aditelik/bldc_controller/AutoBOM.xlsx

ref | value5 | footprint | part | description | Min Quantity | Status
C1 | 10uF | Capacitor_SMD:C_0805_2012Metric_Pad1.15x1.40mm_HandSolder | C_Small | Unpolarized capacitor, small symbol | 2 | None
C10 | 1uF | Capacitor_SMD:C_0805_2012Metric_Pad1.15x1.40mm_HandSolder | C | Unpolarized capacitor | 4 | None
C12 | 0.1uF | Capacitor_SMD:C_0805_2012Metric_Pad1.15x1.40mm_HandSolder | C_Small | Unpolarized capacitor, small symbol | 14 | None
C15 | 22uF | Capacitor_SMD:C_0805_2012Metric_Pad1.15x1.40mm_HandSolder | C | Unpolarized capacitor | 2 | None
C18 | 22pF | Capacitor_SMD:C_0805_2012Metric_Pad1.15x1.40mm_HandSolder | C_Small | Unpolarized capacitor, small symbol | 2 | None
C27 | 10nF | Capacitor_SMD:C_0805_2012Metric_Pad1.15x1.40mm_HandSolder | C_Small | Unpolarized capacitor, small symbol | 1 | None
C28 | 22nF | Capacitor_SMD:C_0805_2012Metric_Pad1.15x1.40mm_HandSolder | C | Unpolarized capacitor | 3 | None
C31 | 1nF | Capacitor_SMD:C_0805_2012Metric_Pad1.15x1.40mm_HandSolder | C_Small | Unpolarized capacitor, small symbol | 1 | None
C32 | 100pF | Capacitor_SMD:C_0805_2012Metric_Pad1.15x1.40mm_HandSolder | C_Small | Unpolarized capacitor, small symbol | 1 | None
C34 | 0.47uF | Capacitor_SMD:C_0805_2012Metric_Pad1.15x1.40mm_HandSolder | C | Unpolarized capacitor | 3 | None
C5 | 0.33uF | Capacitor_SMD:C_0805_2012Metric_Pad1.15x1.40mm_HandSolder | C | Unpolarized capacitor | 1 | None
C6 | 0.22uF | Capacitor_SMD:C_0805_2012Metric_Pad1.15x1.40mm_HandSolder | C | Unpolarized capacitor | 1 | None
D10 | BAT54HT1G | Diode_SMD:D_SOD-323_HandSoldering | 1N914 | 100V 0.3A Small Signal Fast Switching Diode, DO-35 | 2 | None
D12 | SMF12A | Diode_SMD:D_SOD-123F | D_Zener | Zener diode | 1 | None
D13 | SMF5.0A | Diode_SMD:D_SOD-123F | D_Zener | Zener diode | 1 | None
D14 | 1N5819 | Diode_SMD:D_SOD-123 | 1N5818 | 30V 1A Schottky Barrier Rectifier Diode, DO-41 | 3 | None
D2 | LTST-C171KRKT | LED_SMD:LED_0805_2012Metric_Pad1.15x1.40mm_HandSolder | Green LED | Light emitting diode | 5 | None
D3 | LTST-C171GKT | LED_SMD:LED_0805_2012Metric_Pad1.15x1.40mm_HandSolder | Red LED | Light emitting diode | 1 | None
D4 | LTST-C171GKT | LED_SMD:LED_0805_2012Metric_Pad1.15x1.40mm_HandSolder | Blue LED | Light emitting diode | 1 | None
D8 | SMF10A | Diode_SMD:D_SOD-123F | D_Zener | Zener diode | 1 | None
F1 | 5A Fuse | Fuse:Fuse_1206_3216Metric_Pad1.42x1.75mm_HandSolder | Fuse | Fuse | 1 | None
FB1 | BL01RN1A1D2B | Ferrite_THT:Ferrite_Bead_TH | Ferrite_Bead | Ferrite bead | 1 | None
J1 | Conn_01x06_Male | Connector_PinHeader_2.54mm:PinHeader_1x06_P2.54mm_Vertical | Conn_01x06_Male | Generic connector, single row, 01x06, script generated (kicad-library-utils/schlib/autogen/connector/) | 1 | None
J2 | Screw_Terminal_01x04 | Connector:Terminal_Block_4Pin_TH | Screw_Terminal_01x04 | Generic screw terminal, single row, 01x04, script generated (kicad-library-utils/schlib/autogen/connector/) | 1 | None
Q1 |  | Package_TO_SOT_SMD:SOT-23 |  | P-Channel MOSFET, SOT-23 | 1 | None
Q10 | IRLB8721PBF | Package_TO_SOT_THT:TO-220-3_Vertical | IRLB8721PBF | 62A Id, 30V Vds, N-Channel MOSFET, TO-220 | 1 | Some
Q3 | DMN65D8L-7 | Package_TO_SOT_SMD:SOT-23 | DMN67D7L | 0.21A Id, 60V Vds, N-Channel MOSFET, SOT-23 | 2 | None
Q4 | MMBT3904 | Package_TO_SOT_SMD:SOT-23 | MMBT3904 | 0.2A Ic, 40V Vce, Small Signal NPN Transistor, SOT-23 | 1 | None
Q5 | IRF4905 | Package_TO_SOT_THT:TO-220-3_Vertical | IRF4905 | -74A Id, -55V Vds, Single P-Channel HEXFET Power MOSFET, 20mOhm Ron, TO-220AB | 1 | Some
R1 | 1K | Resistor_SMD:R_0805_2012Metric_Pad1.15x1.40mm_HandSolder | R_US | Resistor, US symbol | 11 | None
R11 | 10K | Resistor_SMD:R_0805_2012Metric_Pad1.15x1.40mm_HandSolder | R_US | Resistor, US symbol | 9 | None
R14 | 10 | Resistor_SMD:R_0805_2012Metric_Pad1.15x1.40mm_HandSolder | R_US | Resistor, US symbol | 7 | None
R15 | 100K | Resistor_SMD:R_0805_2012Metric_Pad1.15x1.40mm_HandSolder | R_US | Resistor, US symbol | 7 | None
R19 | 3K | Resistor_SMD:R_0805_2012Metric_Pad1.15x1.40mm_HandSolder | R_US | Resistor, US symbol | 1 | None
R21 | 1 | Resistor_THT:Power_Resistor_TH | R_US | Resistor, US symbol | 5 | Some
R22 | 40K | Resistor_SMD:R_0805_2012Metric_Pad1.15x1.40mm_HandSolder | R_US | Resistor, US symbol | 1 | None
R28 | 4.7 | Resistor_SMD:R_0805_2012Metric_Pad1.15x1.40mm_HandSolder | R_US | Resistor, US symbol | 3 | None
R5 | 800 | Resistor_SMD:R_0805_2012Metric_Pad1.15x1.40mm_HandSolder | R_US | Resistor, US symbol | 1 | None
R7 | 220 | Resistor_SMD:R_0805_2012Metric_Pad1.15x1.40mm_HandSolder | R_US | Resistor, US symbol | 2 | None
R8 | 300 | Resistor_SMD:R_0805_2012Metric_Pad1.15x1.40mm_HandSolder | R_US | Resistor, US symbol | 4 | None
RV1 | 5K | Potentiometer_SMD:Trimmer_Pot_SM | R_POT | Potentiometer | 1 | None
SW1 | 1301.9314 | Button_Switch_SMD:Tactile_Switch_SM | SW_Push | Push button switch, generic, two pins | 1 | None
SW2 | D6C50 F1 LFS | Button_Switch_THT:Pushbutton_Switch_TH | SW_Push | Push button switch, generic, two pins | 1 | None
SW3 | D6C40 F1 LFS | Button_Switch_THT:Pushbutton_Switch_TH | SW_Push | Push button switch, generic, two pins | 1 | None
TP29 | TestPoint | TestPoint:TestPoint_Keystone_5000-5004_Miniature | TestPoint | test point | 4 | None
U1 | ATmega328P-PU | Package_DIP:DIP-28_W7.62mm | ATmega328P-PU | 20MHz, 32kB Flash, 2kB SRAM, 1kB EEPROM, DIP-28 | 1 | Some
U10 | IRS2004 | Package_DIP:DIP-8_W7.62mm | IRS2004 | Half-Bridge Driver, 200V, 290/600mA, PDIP-8/SOIC-8 | 2 | Some
U2 | SN74LVC1G11DBVR | Package_TO_SOT_SMD:SOT-23-6_Handsoldering | SN74LVC1G11DBVR |  | 3 | None
U3 | uA7810 | Package_TO_SOT_THT:TO-220-3_Vertical | uA7810 | Positive 1A 35V Linear Regulator, Fixed Output 10V, TO-220/TO-263 | 1 | Some
U4 | LM7805_TO220 | Package_TO_SOT_THT:TO-220-3_Vertical | LM7805_TO220 | Positive 1A 35V Linear Regulator, Fixed Output 5V, TO-220 | 1 | Some
U5 | CD4044BE | Package_DIP:DIP-16_W7.62mm | CD4044BE |  | 3 | None
U7 | MCP601-xP | Package_DIP:DIP-8_W7.62mm | MCP601-xP | Single 2.7V to 6.0V Single Supply CMOS Op Amps, DIP-8 | 3 | None
Y1 | 9B-16.000MBBK-B | Crystal:Crystal_16MHz_TH | Crystal | Two pin crystal | 1 | Some
