aditelik/bldc_controller/bldc_controller.pdf

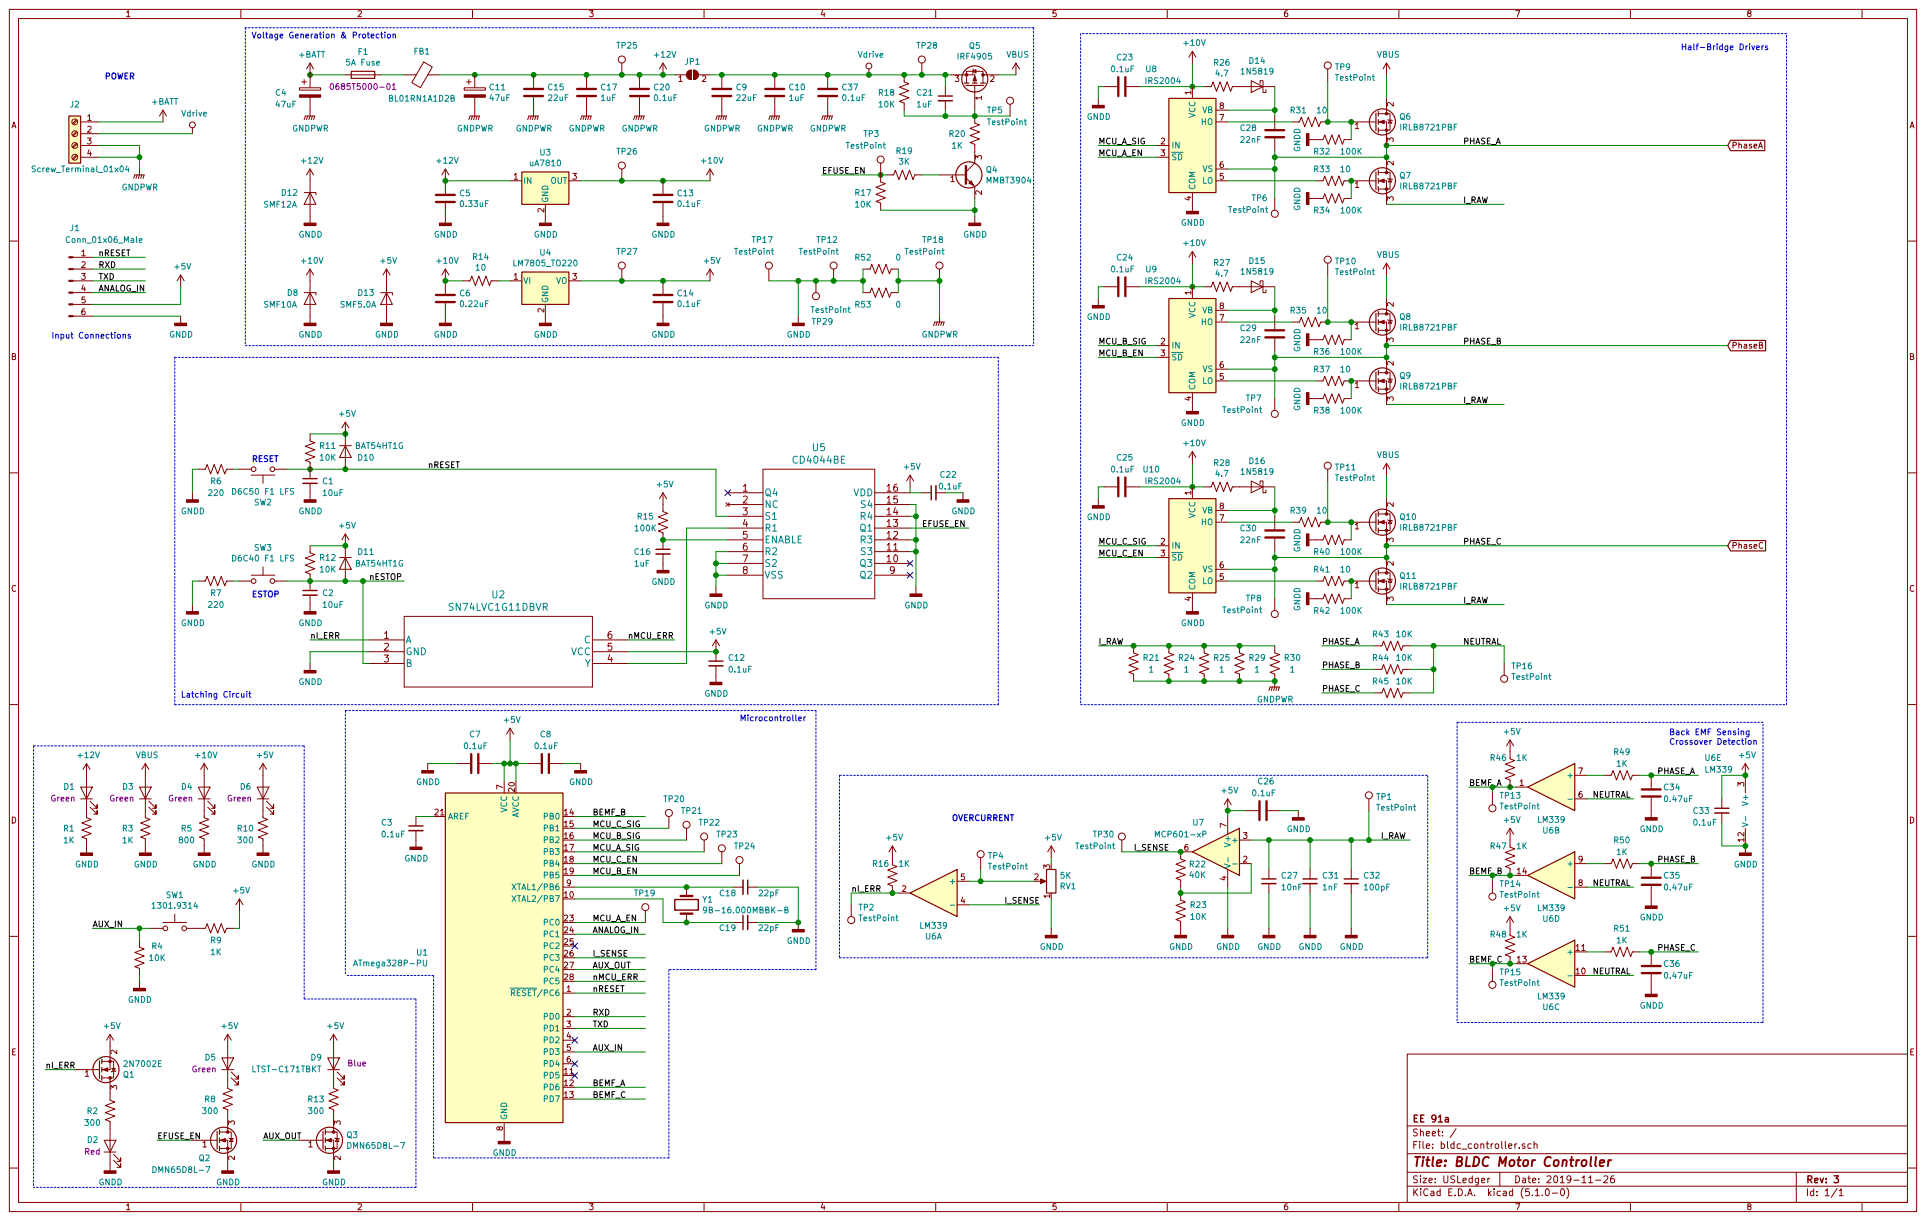
[picture p1: page 1]

Id: 1/1 Title: BLDC Motor Controller
