aditelik/bldc_controller/(commit log)

2019-11-04 Update Filenames
    [bldc_controller.sch]
2019-11-04 Update Schematic
    [bldc_controller.sch]
2019-11-04 adding power simulations
2019-11-04 Fix pMOSFET on Power Sim
2019-11-18 Basically Ready for Layout
    [bldc_controller.sch]
2019-11-18 Ready for Layout
    [bldc_controller.sch]
2019-11-18 Ready to Route
    [bldc_controller.kicad_pcb, bldc_controller.sch]
2019-11-18 Done with First Pass of Layout
    [bldc_controller.kicad_pcb, bldc_controller.sch]
2019-11-18 Forgot a Connection
    [bldc_controller.kicad_pcb]
2019-11-18 added vias for motor
    [bldc_controller.sch]
2019-11-19 finished labelling
    [bldc_controller.kicad_pcb]
2019-11-19 fixed small bug
    [bldc_controller.kicad_pcb]
2019-11-19 fixed wire thickness
    [bldc_controller.kicad_pcb]
2019-11-22 Manual Revert
    [bldc_controller.kicad_pcb, bldc_controller.sch]
2019-11-22 Added some shapes
    [bldc_controller.kicad_pcb, bldc_controller.sch]
2019-11-22 Finished Ground Planes
    [bldc_controller.kicad_pcb, bldc_controller.sch]
2019-11-22 Almost Done with Layout V2
    [bldc_controller.kicad_pcb, bldc_controller.sch]
2019-11-22 Just Need to Fix Silkscreen
    [bldc_controller.kicad_pcb, bldc_controller.sch]
2019-11-22 Just Need to Fix Bottom Silkscreen
    [bldc_controller.kicad_pcb, bldc_controller.sch]
2019-11-22 V2 Ready for Fab
    [bldc_controller.kicad_pcb]
2019-11-22 Need to check if output vias are plated
    [bldc_controller.kicad_pcb, bldc_controller.sch]
2019-11-23 Ready for Fab Actually
    [bldc_controller.kicad_pcb]
2019-11-23 Added Preliminary BOMs
    [AutoBOM.xlsx, bldc_controller.sch]
2019-11-23 Fixed PMOS footprint
    [AutoBOM.xlsx, bldc_controller.kicad_pcb, bldc_controller.sch]
2019-11-25 Files that were Sent for Fab
    [bldc_controller.kicad_pcb]
2019-11-26 Added Final Digikey BOM
    [EE91_Digikey_BOM_V4.csv]
2019-11-26 cleaned up schematic
    [bldc_controller.sch]
